binaraherath/Distributed_BMS/images/battery.jpeg

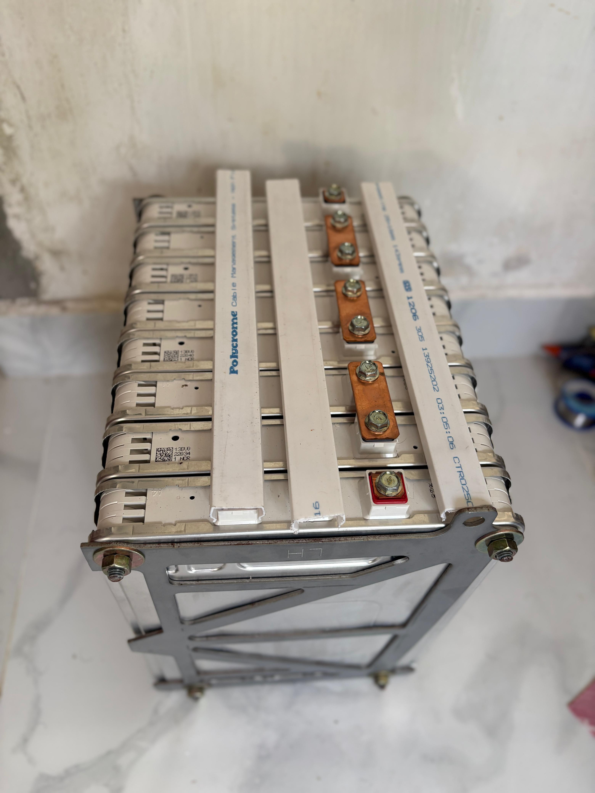
images/battery.jpeg
