binaraherath/Distributed_BMS/images/BQ.png

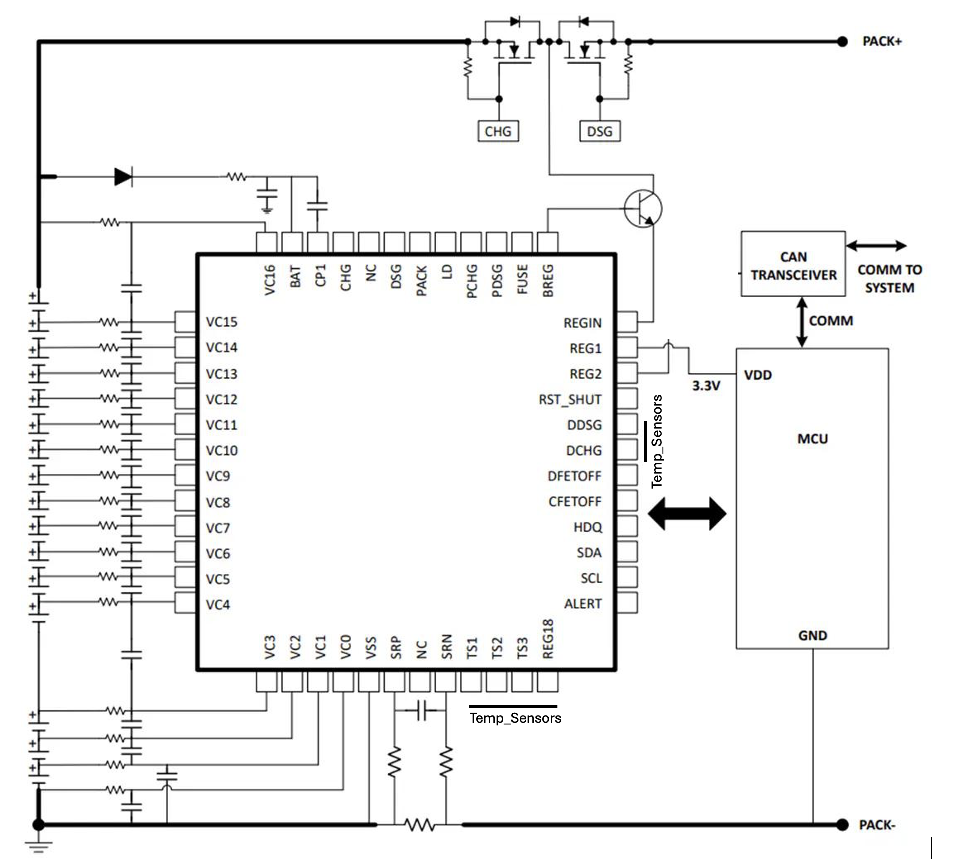
images/BQ.png
