binaraherath/Distributed_BMS/images/node1.png

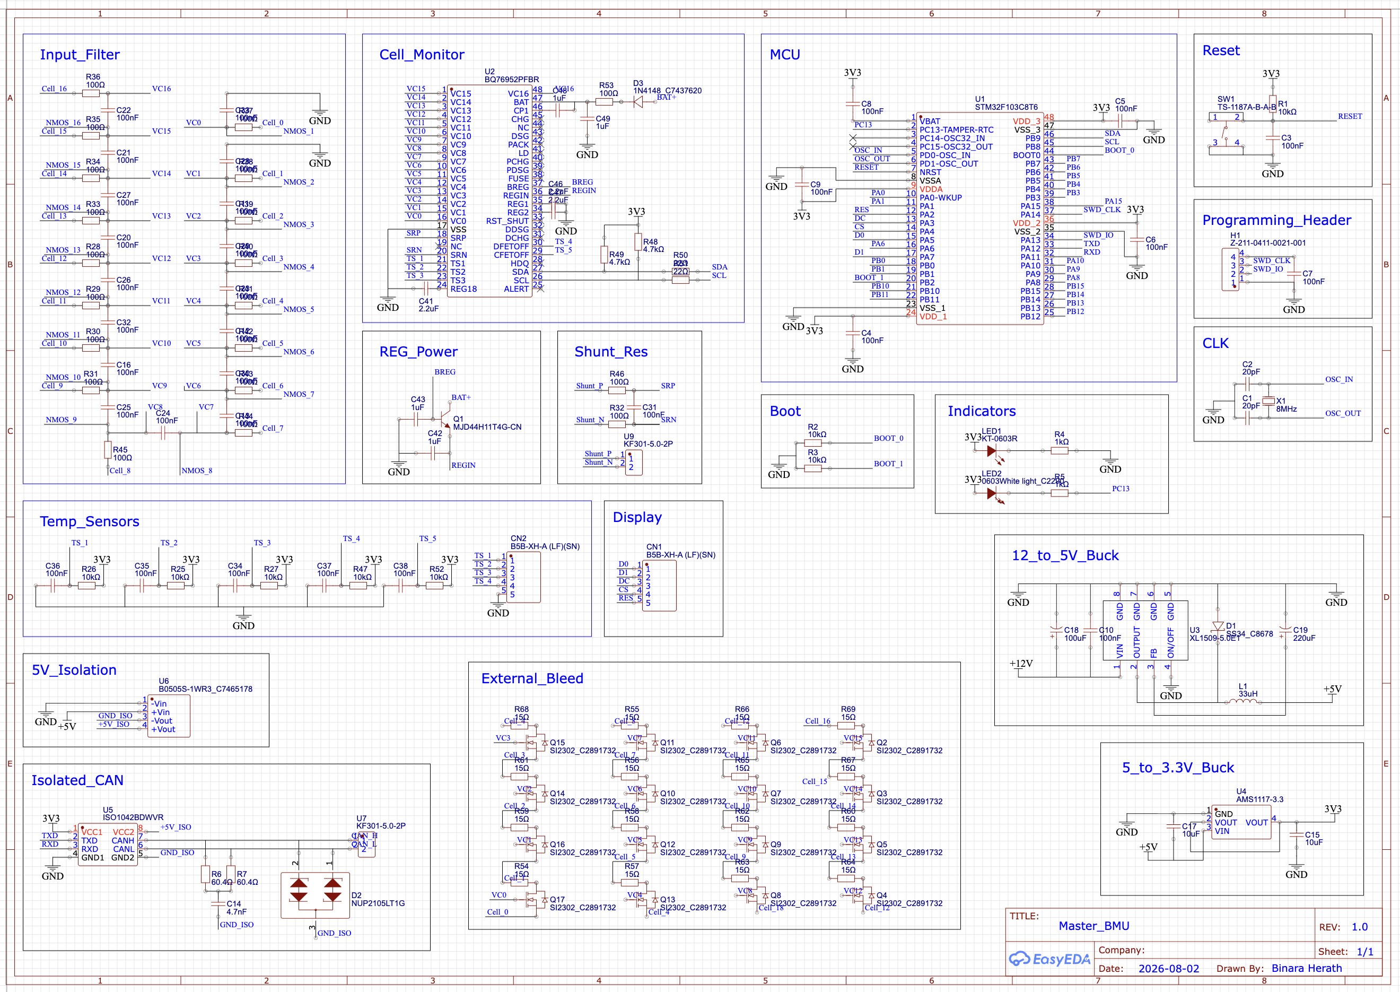
images/node1.png
