binaraherath/Distributed_BMS/images/PCB-2D.png

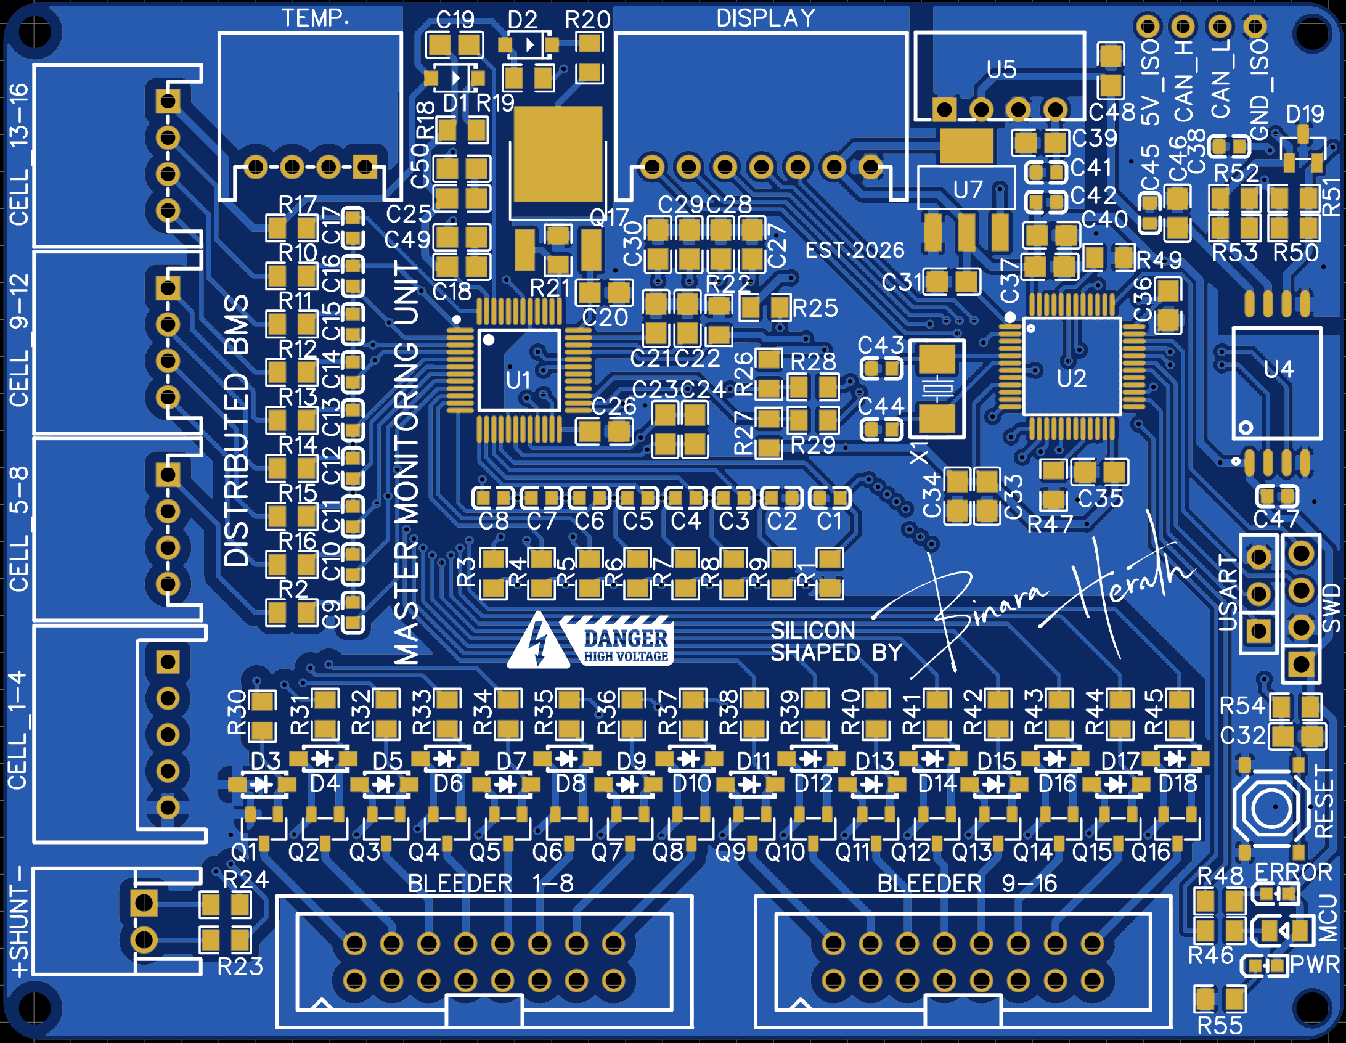
images/PCB-2D.png
