binaraherath/Distributed_BMS/images/prototype.jpeg

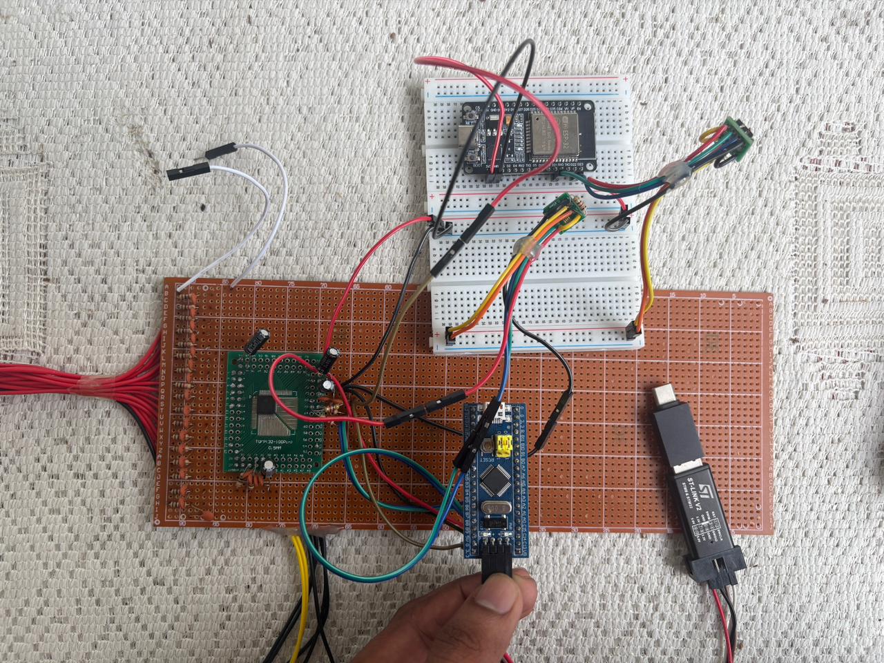
images/prototype.jpeg
