binaraherath/Distributed_BMS/PCB/BOM_bms_2026-09-23.csv

ID | Name | Designator | Footprint | Quantity | Manufacturer Part | Manufacturer | Supplier | Supplier Part | Price | Pins | 3DModel | Contributor | JLCPCB Part Class | link
1 | DC3-2.54-16PAS | BLEEDER_1-8,BLEEDER_9-16 | IDC-TH_16P-P2.54_C3406 | 2 | DC3-2.54-16PAS | ZHOURI(洲日) | LCSC | C2977594 | 0.097 | 16 | IDC-TH_16P-P2.54-V-R2-C8-S2.54 | lcsc | Extended Part | https://item.szlcsc.com/3807.html
2 | S5B-XH-A(LF)(SN) | CELL_1-4 | CONN-TH_5P-P2.50_S5B-XH-A-LF-SN | 1 | S5B-XH-A(LF)(SN) | JST | LCSC | C263757 | 0.158 | 5 | CONN-TH_5P-P2.50_S5B-XH-A-LF-SN | LCSC | Extended Part | https://lcsc.com/product-detail/Wire-To-Board-Wire-To-Wire-Connector_JST-Sales-America_S5B-XH-A-LF-SN_JST-Sales-America-S5B-XH-A-LF-SN_C263757.html
3 | S4B-XH-A (LF)(SN) | CELL_5-8,CELL_9-12,CELL_13-16,TEMP. | CONN-TH_S4B-XH-A-LF-SN | 4 | S4B-XH-A(LF)(SN) | JST | LCSC | C157925 | 0.09 | 4 | CONN-TH_S4B-XH-A-LF-SN | LCSC | Extended Part | https://item.szlcsc.com/169273.html
4 | S7B-XH-A (LF)(SN) | DISPLAY | CONN-TH_S7B-XH-A-LF-SN | 1 | S7B-XH-A(LF)(SN) | JST | LCSC | C157916 | 0.174 | 7 | CONN-TH_S7B-XH-A-LF-SN | LCSC | Extended Part | https://item.szlcsc.com/169273.html
5 | KT-0603R | PWR,ERROR | LED-SMD_L1.6-W0.8-R-RD | 2 | KT-0603R | KENTO | LCSC | C2286 | 0.008 | 2 | LED0603_L1.6-W0.8-H0.6 | lcsc | Basic Part | https://item.szlcsc.com/347796.html
6 | TS-1187A-B-A-B | RESET | SW-SMD_4P-L5.1-W5.1-P3.70-LS6.5-TL_H1.5 | 1 | TS-1187A-B-A-B | XKB Connection(中国星坤) | LCSC | C318884 | 0.021 | 4 | SW-SMD_4P-L5.1-W5.1-P3.70-LS6.5-TL_H1.5 | LCSC | Basic Part | https://item.szlcsc.com/datasheet/TS-1187A-C-6.0-B/299982.html
7 | S2B-XH-A-1 (LF)(SN) | +SHUNT- | CONN-TH_S2B-XH-A-1-LF-SN | 1 | S2B-XH-A-1(LF)(SN) | JST | LCSC | C163035 | 0.1 | 2 | CONN-TH_S2B-XH-A-1-LF-SN | LCSC | Extended Part | https://atta.szlcsc.com/upload/public/pdf/source/20180323/44523D67FD27A22AE4980410C4D95A91.pdf
8 | Header-Male-2.54_1x4 | SWD | HDR-TH_4P-P2.54-V-M | 1 | B-2100S04P-A110 | Ckmtw(灿科盟) | LCSC | C124378 | 0.057 | 4 | HDR-TH_4P-P2.54-M-LI-1X4P | LCSC | Extended Part | https://item.szlcsc.com/502959.html
9 | Header-Female-2.54_1x3 | USART | HDR-TH_3P-P2.54-V-F | 1 | 2.54-1*3P母 | BOOMELE(博穆精密) | LCSC | C146243 | 0.065 | 3 | HDR2.54-F-LI-1X3P | lcsc | Extended Part | https://item.szlcsc.com/562471.html
10 | 0805G (Green) | MCU | LED0805-R-RD | 1 | KT-0805G | KENTO | LCSC | C2297 | 0.017 | 2 | LED0805-RD | lcsc | Basic Part | https://item.szlcsc.com/88042.html
11 | 220nF | C1,C2,C3,C4,C5,C6,C7,C8,C9,C10,C11,C12,C13,C14,C15,C16,C17 | C0603 | 17 | CL10B224KA8NNNC | SAMSUNG(三星) | LCSC | C21120 | 0.014 | 2 | C0603_L1.6-W0.8-H0.8 | lcsc | Basic Part | https://item.szlcsc.com/362304.html
12 | 4.7nF | C38 | C0603 | 1 | 0603B472K500NT | FH(风华) | LCSC | C53987 | 0.009 | 2 | C0603_L1.6-W0.8-H0.8 | lcsc | Basic Part | https://item.szlcsc.com/362304.html
13 | 100nF | C41,C42,C45,C47 | C0603 | 4 | CC0603KRX7R9BB104 | YAGEO(国巨) | LCSC | C14663 | 0.013 | 2 | C0603_L1.6-W0.8-H0.8 | lcsc | Basic Part | https://item.szlcsc.com/362304.html
14 | 30pF | C43,C44 | C0603 | 2 | 0603CG300J500NT | FH(风华) | LCSC | C1658 | 0.008 | 2 | C0603_L1.6-W0.8-H0.8 | lcsc | Basic Part | https://item.szlcsc.com/362304.html
15 | 470nF | C19 | C0805 | 1 | CL21B474KBFNNNE | SAMSUNG(三星) | LCSC | C13967 | 0.023 | 2 | C0805_L2.0-W1.3-H1.3 | lcsc | Basic Part | https://item.szlcsc.com/373011.html
16 | 22nF | C20 | C0805 | 1 | CL21B223KBANNNC | SAMSUNG(三星) | LCSC | C1729 | 0.01 | 2 | C0805_L2.0-W1.3-H1.3 | lcsc | Basic Part | https://item.szlcsc.com/373011.html
17 | 2.2uF | C21,C22,C26,C49,C18 | C0805 | 5 | CL21A225KBQNNNE | SAMSUNG(三星) | LCSC | C377773 | 0.054 | 2 | C0805_L2.0-W1.3-H1.3 | LCSC | Basic Part | https://item.szlcsc.com/373011.html
18 | 100nF | C23,C31,C32,C35,C36,C37 | C0805 | 6 | CC0805KRX7R9BB104 | YAGEO(国巨) | LCSC | C49678 | 0.02 | 2 | C0805_L2.0-W1.3-H1.3 | lcsc | Basic Part | https://item.szlcsc.com/373011.html
19 | 100pF | C24 | C0805 | 1 | CL21C101JBANNNC | SAMSUNG(三星) | LCSC | C1790 | 0.01 | 2 | C0805_L2.0-W1.3-H1.3 | lcsc | Basic Part | https://item.szlcsc.com/373011.html
20 | 2.2nF | C27,C28,C29,C30 | C0805 | 4 | CL21C222JBFNNNE | SAMSUNG(三星) | LCSC | C28260 | 0.026 | 2 | C0805_L2.0-W1.3-H1.3 | lcsc | Basic Part | https://item.szlcsc.com/373011.html
21 | 1uF | C33 | C0805 | 1 | CL21B105KBFNNNE | SAMSUNG(三星) | LCSC | C28323 | 0.04 | 2 | C0805_L2.0-W1.3-H1.3 | lcsc | Basic Part | https://item.szlcsc.com/373011.html
22 | 10nF | C34 | C0805 | 1 | CL21B103KBANNNC | SAMSUNG(三星) | LCSC | C1710 | 0.012 | 2 | C0805_L2.0-W1.3-H1.3 | lcsc | Basic Part | https://item.szlcsc.com/373011.html
23 | 10uF | C39,C40,C46 | C0805 | 3 | CL21A106KAYNNNE | SAMSUNG(三星) | LCSC | C15850 | 0.08 | 2 | C0805_L2.0-W1.3-H1.3 | lcsc | Basic Part | https://item.szlcsc.com/373011.html
24 | 4.7uF | C48 | C0805 | 1 | CL21A475KAQNNNE | SAMSUNG(三星) | LCSC | C1779 | 0.035 | 2 | C0805_L2.0-W1.3-H1.3 | lcsc | Basic Part | https://item.szlcsc.com/373011.html
25 | 1N4148W_C7420318 | D1,D2 | SOD-123_L2.7-W1.6-LS3.7-FD | 2 | 1N4148W | R+O(宏嘉诚) | LCSC | C7420318 | 0.007 | 2 | SOD-123_L2.7-W1.6-LS3.7-FD | lcsc | Extended Part | https://atta.szlcsc.com/upload/public/pdf/source/20180503/C191428_AD0ED457CC768099CBC92C1868282AFA.pdf
26 | B5819W_C8598 | D3,D4,D5,D6,D7,D8,D9,D10,D11,D12,D13,D14,D15,D16,D17,D18 | SOD-123_L2.7-W1.6-LS3.7-RD-1 | 16 | B5819W SL | CJ(江苏长电/长晶) | LCSC | C8598 | 0.028 | 2 | SOD-123_L2.7-W1.6-LS3.7-RD-1 | lcsc | Basic Part | https://atta.szlcsc.com/upload/public/pdf/source/20210423/C2828417_EF1BF8BE3D48F97E320B09B073C89160.pdf
27 | NUP2105LT1G | D19 | SOT-23-3_L2.9-W1.3-P1.90-LS2.4-BL-2 | 1 | NUP2105LT1G | onsemi(安森美) | LCSC | C14486 | 0.084 | 3 | SOT-23-3_L2.9-W1.3-P1.90-LS2.4 | lcsc | Extended Part | https://atta.szlcsc.com/upload/public/pdf/source/20230202/4B050FD87E409CF6352A84D0F2147E80.pdf
28 | MMBT2222A_C8512 | Q1,Q2,Q3,Q4,Q5,Q6,Q7,Q8,Q9,Q10,Q11,Q12,Q13,Q14,Q15,Q16 | SOT-23-3_L2.9-W1.3-P1.90-LS2.4-BR | 16 | MMBT2222A 1P | CJ(江苏长电/长晶) | LCSC | C8512 | 0.018 | 3 | SOT-23-3P_L2.9-W1.3-H1.0-LS2.4-P0.95 | lcsc | Basic Part | https://www.diodes.com/assets/Package-Files/SOT23.pdf
29 | MJD44H11T4G-CN | Q17 | TO-252-2_L6.6-W6.1-P4.57-LS10.0-BR-CW | 1 | MJD44H11T4G-CN | ChipNobo(无边界) | LCSC | C49006717 | 0.27 | 3 | TO-252-2_L6.6-W6.1-P4.57-LS10.0-BR-CW | lcsc | Extended Part | https://atta.szlcsc.com/upload/public/pdf/source/20180730/C256463_B17347F79758AD9067BF3A09DDCB423D.pdf
30 | 100Ω | R1,R2,R3,R4,R5,R6,R7,R8,R9,R10,R11,R12,R13,R14,R15,R16,R18,R23,R24 | R0805 | 19 | 0805W8F1000T5E | UNI-ROYAL(厚声) | LCSC | C17408 | 0.004 | 2 | R0805_L2.0-W1.3-H0.6 | lcsc | Basic Part | https://item.szlcsc.com/142685.html
31 | 20Ω | R17 | R0805 | 1 | 0805W8F200JT5E | UNI-ROYAL(厚声) | LCSC | C17544 | 0.005 | 2 | R0805_L2.0-W1.3-H0.6 | lcsc | Basic Part | https://item.szlcsc.com/142685.html
32 | 10kΩ | R19,R22,R25,R47,R49,R54 | R0805 | 6 | 0805W8F1002T5E | UNI-ROYAL(厚声) | LCSC | C17414 | 0.004 | 2 | R0805_L2.0-W1.3-H0.6 | lcsc | Basic Part | https://item.szlcsc.com/142685.html
33 | 300Ω | R20 | R0805 | 1 | 0805W8F3000T5E | UNI-ROYAL(厚声) | LCSC | C17617 | 0.005 | 2 | R0805_L2.0-W1.3-H0.6 | lcsc | Basic Part | https://item.szlcsc.com/142685.html
34 | 10MΩ | R21 | R0805 | 1 | RMC 0805 10M F N | Tyohm(幸亚电阻) | LCSC | C325949 | 0.008 | 2 | R0805_L2.0-W1.3-H0.6 | LCSC | Extended Part | https://item.szlcsc.com/142685.html
35 | 4.7kΩ | R26,R27 | R0805 | 2 | 0805W8F4701T5E | UNI-ROYAL(厚声) | LCSC | C17673 | 0.005 | 2 | R0805_L2.0-W1.3-H0.6 | lcsc | Basic Part | https://item.szlcsc.com/142685.html
36 | 22Ω | R28,R29 | R0805 | 2 | 0805W8F220JT5E | UNI-ROYAL(厚声) | LCSC | C17561 | 0.005 | 2 | R0805_L2.0-W1.3-H0.6 | lcsc | Basic Part | https://item.szlcsc.com/142685.html
37 | 220Ω | R30,R31,R32,R33,R34,R35,R36,R37,R38,R39,R40,R41,R42,R43,R44,R45 | R0805 | 16 | 0805W8F2200T5E | UNI-ROYAL(厚声) | LCSC | C17557 | 0.006 | 2 | R0805_L2.0-W1.3-H0.6 | lcsc | Basic Part | https://item.szlcsc.com/142685.html
38 | 1kΩ | R46,R48,R55 | R0805 | 3 | 0805W8F1001T5E | UNI-ROYAL(厚声) | LCSC | C17513 | 0.004 | 2 | R0805_L2.0-W1.3-H0.6 | lcsc | Basic Part | https://item.szlcsc.com/142685.html
39 | 120Ω | R50,R51,R52,R53 | R0805 | 4 | 0805W8F1200T5E | UNI-ROYAL(厚声) | LCSC | C17437 | 0.007 | 2 | R0805_L2.0-W1.3-H0.6 | lcsc | Basic Part | https://item.szlcsc.com/142685.html
40 | BQ76952PFBR | U1 | TQFP-48_L7.0-W7.0-P0.50-LS9.0-BL | 1 | BQ76952PFBR | TI(德州仪器) | LCSC | C2862742 | 3.309 | 48 | TQFP-48_L7.0-W7.0-H1.2-LS9.0-P0.50 | LCSC | Extended Part | https://item.szlcsc.com/79128.html
41 | STM32F103C8T6 | U2 | LQFP-48_L7.0-W7.0-P0.50-LS9.0-BL | 1 | STM32F103C8T6 | ST(意法半导体) | LCSC | C8734 | 1.626 | 48 | LQFP-48_L7.0-W7.0-H1.4-LS9.0-P0.50 | lcsc | Extended Part | https://atta.szlcsc.com/upload/public/pdf/source/20190808/C411336_D1D2DF7683029D856BA010BA7A5BF7EA.pdf
42 | ISO1042BDWVR | U4 | SOIC-8_L5.9-W7.5-P1.27-LS11.5-BL | 1 | ISO1042BDWVR | TI(德州仪器) | LCSC | C484409 | 2.45 | 8 | SOIC-8_L5.8-W7.5-H2.3-LS11.5-P1.27 | LCSC | Extended Part | https://item.szlcsc.com/209718.html
43 | B0505S-1WR3L_C22749776 | U5 | PWRM-TH_B0505S-1WR3L | 1 | B0505S-1WR3L | YLPTEC(易川) | LCSC | C22749776 | 1.01 | 4 | PWRM-TH_B0505S-1WR3L | lcsc | Extended Part | https://atta.szlcsc.com/upload/public/pdf/source/20240807/C6648B843069D054DBBCD1ED78E6F415.pdf
44 | AMS1117-3.3 | U7 | SOT-223-3_L6.5-W3.4-P2.30-LS7.0-BR | 1 | AMS1117-3.3 | Advanced Monolithic Systems | LCSC | C6186 | 0.22 | 4 | SOT-223-4P_L6.5-W3.5-H1.6-LS7.0-P2.30 | lcsc | Basic Part | https://item.szlcsc.com/410724.html
45 | 8MHz | X1 | CRYSTAL-SMD_L5.0-W3.2 | 1 | X50328MSB2GI | YXC(扬兴晶振) | LCSC | C115962 | 0.248 | 2 | CRYSTAL-SMD_L5.0-W3.2 | lcsc | Basic Part | https://atta.szlcsc.com/upload/public/pdf/source/20181112/C254399_C5BBDD3824DCEC70A37F176D8FB90B40.pdf
46 | 220pF | C50,C25 | C0805 | 2 | CC0805KRX7R9BB221 | YAGEO(国巨) | LCSC | C107145 | 0.01 | 2 | C0805_L2.0-W1.3-H1.3 | lcsc | Basic Part | https://item.szlcsc.com/373011.html
