binaraherath/Distributed_BMS/(list of files, drawings)

Other design files:
PCB/PCB_PCB_bms_2026-09-23.json
PCB/SCH_bms_2026-09-23.json
