binaraherath/Distributed_BMS/BMS_Node1/Core/Src/main.c

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
/* Includes ------------------------------------------------------------------*/
#include "main.h"

/* USER CODE BEGIN Includes */
#include "bms_config.h"
#include "bq76952.h"
#include "bms_app.h"
#include "bms_can.h"
#if (BMS_USE_OLED == 1)
#include "ssd1306.h"
#endif
#include <stdio.h>
#include <string.h>
/* USER CODE END Includes */

CAN_HandleTypeDef hcan;

I2C_HandleTypeDef hi2c1;

SPI_HandleTypeDef hspi1;

UART_HandleTypeDef huart1;

IWDG_HandleTypeDef hiwdg;

/* USER CODE BEGIN PV */
static volatile bool s_bq_alert = false;   /* set by the BQ ALERT EXTI */
/* USER CODE END PV */

void SystemClock_Config(void);
static void MX_GPIO_Init(void);
static void MX_CAN_Init(void);
static void MX_I2C1_Init(void);
static void MX_USART1_UART_Init(void);
static void MX_SPI1_Init(void);
static void MX_IWDG_Init(void);
/* USER CODE BEGIN PFP */
static void DebugPrint(const char *s);
static void StartupSelfTest(void);
/* USER CODE END PFP */

/* USER CODE BEGIN 0 */

static void DebugPrint(const char *s)
{
#if (BMS_USE_UART_DEBUG == 1)
    HAL_UART_Transmit(&huart1, (uint8_t *)s, (uint16_t)strlen(s), 100);
#else
    (void)s;
#endif
}

/**
 * Bring the BQ76952 up and prove it is configured the way we think it is.
 * Any failure here latches a fault -- the node keeps running and keeps
 * reporting, but the safety output stays low.
 */
static void StartupSelfTest(void)
{
    char msg[80];
    BQ_Status_t st;

    BQ76952_Attach(&hi2c1);

    st = BQ76952_Probe();
    if (st != BQ_OK) {
        snprintf(msg, sizeof(msg), "BQ probe FAILED: %s\r\n",
                 BQ76952_StatusName(st));
        DebugPrint(msg);
        g_bms.faults |= BMS_FAULT_BQ_COMMS;
        return;
    }
    DebugPrint("BQ76952 detected (0x7695)\r\n");

    st = BQ76952_Configure();
    if (st != BQ_OK) {
        snprintf(msg, sizeof(msg), "BQ config FAILED: %s\r\n",
                 BQ76952_StatusName(st));
        DebugPrint(msg);
        g_bms.faults |= BMS_FAULT_BQ_CONFIG;
        return;
    }
    DebugPrint("BQ76952 configured and verified\r\n");
}

/* CAN RX interrupt. Reading the message clears the pending flag, so this
 * callback must actually drain the FIFO or the ISR will re-fire forever. */
void HAL_CAN_RxFifo0MsgPendingCallback(CAN_HandleTypeDef *h)
{
    (void)h;
    BMS_CAN_Poll();
}

void HAL_CAN_ErrorCallback(CAN_HandleTypeDef *h)
{
    if (READ_BIT(h->Instance->ESR, CAN_ESR_BOFF) != 0u) {
        g_bms.faults |= BMS_FAULT_CAN_BUS_OFF;
    }
}

void HAL_GPIO_EXTI_Callback(uint16_t pin)
{
    if (pin == BQ_ALERT_Pin) s_bq_alert = true;
}

/* USER CODE END 0 */

/**
  * @brief  The application entry point.
  * @retval int
  */
int main(void)
{
  /* USER CODE BEGIN 1 */
  uint32_t t_meas = 0, t_fast = 0, t_slow = 0, t_hb = 0, t_bal = 0, t_oled = 0;
  uint32_t last_faults = 0;
  /* USER CODE END 1 */

  /* MCU Configuration--------------------------------------------------------*/
  HAL_Init();

  SystemClock_Config();

  /* Initialize all configured peripherals */
  MX_GPIO_Init();
  MX_CAN_Init();
  MX_I2C1_Init();
  MX_USART1_UART_Init();
  MX_SPI1_Init();

  /* USER CODE BEGIN 2 */
  DebugPrint("\r\n=== 16S BMS monitoring node ===\r\n");

  BMS_App_Init();

  if (BMS_CAN_Init(&hcan) != HAL_OK) {
      DebugPrint("CAN init FAILED\r\n");
      g_bms.faults |= BMS_FAULT_CAN_BUS_OFF;
  } else {
      DebugPrint("CAN 500 kbit/s up\r\n");
  }

#if (BMS_USE_OLED == 1)
  SSD1306_Init(&hspi1);
#endif

  StartupSelfTest();

  /* Watchdog last, so a slow BQ configuration cannot trip it. */
  MX_IWDG_Init();
  /* USER CODE END 2 */

  /* Infinite loop */
  /* USER CODE BEGIN WHILE */
  while (1)
  {
    uint32_t now = HAL_GetTick();

    /* --- 100 ms: measure and evaluate ---------------------------------- */
    if ((now - t_meas) >= BMS_MEAS_PERIOD_MS) {
        t_meas = now;
        BMS_App_MeasureAndEvaluate();

        if (s_bq_alert) {
            s_bq_alert = false;
            /* The next scheduled read already picks up the new safety status;
             * the flag is here so you can see the pin working during bring-up. */
        }
    }

    /* --- 100 ms: fast CAN group ---------------------------------------- */
    if ((now - t_fast) >= BMS_CAN_FAST_PERIOD_MS) {
        t_fast = now;
        BMS_CAN_SendFast();
    }

    /* --- immediate fault frame on any change --------------------------- */
    if (g_bms.faults != last_faults) {
        last_faults = g_bms.faults;
        BMS_CAN_SendFaultsNow();
    }

    /* --- 500 ms: slow CAN group ---------------------------------------- */
    if ((now - t_slow) >= BMS_CAN_SLOW_PERIOD_MS) {
        t_slow = now;
        BMS_CAN_SendSlow();
    }

    /* --- 1 s: heartbeat, housekeeping, LED ----------------------------- */
    if ((now - t_hb) >= BMS_CAN_HEARTBEAT_MS) {
        t_hb = now;
        BMS_App_Tick1s();
        BMS_CAN_SendHeartbeat();
        HAL_GPIO_TogglePin(HB_LED_GPIO_Port, HB_LED_Pin);
    }

    /* --- 1 s: balancing ------------------------------------------------- */
    if ((now - t_bal) >= BMS_BALANCE_PERIOD_MS) {
        t_bal = now;
        BMS_App_UpdateBalancing();
    }

    /* --- 250 ms: display ------------------------------------------------ */
#if (BMS_USE_OLED == 1)
    if ((now - t_oled) >= BMS_OLED_PERIOD_MS) {
        t_oled = now;
        SSD1306_RenderBms();
    }
#else
    (void)t_oled;
#endif

    /* --- backstop RX poll ---------------------------------------------- */
    BMS_CAN_Poll();

    /* --- watchdog -------------------------------------------------------
     * Only refresh while measurements are fresh. If the BQ read loop stalls,
     * the watchdog resets the MCU, BMS_OK drops to its pull-down and the
     * system controller opens the contactors. That is the point of it.      */
#if (BMS_USE_IWDG == 1)
    if ((HAL_GetTick() - g_bms.last_good_meas_ms) < BMS_BQ_COMMS_TIMEOUT_MS ||
        (g_bms.faults & BMS_FAULT_BQ_COMMS)) {
        HAL_IWDG_Refresh(&hiwdg);
    }
#endif

    /* USER CODE END WHILE */

    /* USER CODE BEGIN 3 */
  }
  /* USER CODE END 3 */
}

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
