binaraherath/Distributed_BMS/Firmware/Node1_Monitoring_Unit/Core/Inc/main.h

#define LED_MCU_Pin GPIO_PIN_13
#define LED_MCU_GPIO_Port GPIOC
#define OLED_RES_Pin GPIO_PIN_2
#define OLED_RES_GPIO_Port GPIOA
#define OLED_DC_Pin GPIO_PIN_3
#define OLED_DC_GPIO_Port GPIOA
#define OLED_CS_Pin GPIO_PIN_4
#define OLED_CS_GPIO_Port GPIOA
#define LED_ERROR_Pin GPIO_PIN_13
#define LED_ERROR_GPIO_Port GPIOB
#define BQ_RST_SHUT_Pin GPIO_PIN_14
#define BQ_RST_SHUT_GPIO_Port GPIOB
#define BQ_ALERT_Pin GPIO_PIN_5
#define BQ_ALERT_GPIO_Port GPIOB
#define BQ_ALERT_EXTI_IRQn EXTI9_5_IRQn
