binaraherath/Distributed_BMS/Software/backend/src/main/java/io/github/binaraherath/dbms/auth/SecurityConfig.java

package io.github.binaraherath.dbms.auth;

import java.nio.charset.StandardCharsets;

import javax.crypto.SecretKey;
import javax.crypto.spec.SecretKeySpec;

import org.springframework.context.annotation.Bean;
import org.springframework.context.annotation.Configuration;
import org.springframework.http.HttpMethod;
import org.springframework.security.authentication.AuthenticationManager;
import org.springframework.security.authentication.ProviderManager;
import org.springframework.security.authentication.dao.DaoAuthenticationProvider;
import org.springframework.security.config.annotation.method.configuration.EnableMethodSecurity;
import org.springframework.security.config.annotation.web.builders.HttpSecurity;
import org.springframework.security.config.annotation.web.configurers.AbstractHttpConfigurer;
import org.springframework.security.config.http.SessionCreationPolicy;
import org.springframework.security.core.userdetails.User;
import org.springframework.security.core.userdetails.UserDetailsService;
import org.springframework.security.core.userdetails.UsernameNotFoundException;
import org.springframework.security.crypto.factory.PasswordEncoderFactories;
import org.springframework.security.crypto.password.PasswordEncoder;
import org.springframework.security.oauth2.jose.jws.MacAlgorithm;
import org.springframework.security.oauth2.jwt.JwtDecoder;
import org.springframework.security.oauth2.jwt.JwtEncoder;
import org.springframework.security.oauth2.jwt.NimbusJwtDecoder;
import org.springframework.security.oauth2.jwt.NimbusJwtEncoder;
import org.springframework.security.web.SecurityFilterChain;

import com.nimbusds.jose.jwk.source.ImmutableSecret;

import io.github.binaraherath.dbms.config.BmsProperties;
import io.github.binaraherath.dbms.user.AppUserRepository;
import jakarta.servlet.DispatcherType;

/**
 * Stateless security: the login endpoint issues a signed JWT inside an httpOnly,
 * SameSite=Strict cookie. Spring's OAuth2 resource-server support validates it on
 * every request. Roles are checked per endpoint with {@code @PreAuthorize}.
 */
@Configuration(proxyBeanMethods = false)
@EnableMethodSecurity
class SecurityConfig {

    @Bean
    SecretKey jwtKey(BmsProperties props) {
        byte[] secret = props.security().jwtSecret().getBytes(StandardCharsets.UTF_8);
        if (secret.length < 32) {
            throw new IllegalStateException("bms.security.jwt-secret must be at least 32 bytes");
        }
        return new SecretKeySpec(secret, "HmacSHA256");
    }

    @Bean
    JwtEncoder jwtEncoder(SecretKey key) {
        return new NimbusJwtEncoder(new ImmutableSecret<>(key));
    }

    @Bean
    JwtDecoder jwtDecoder(SecretKey key) {
        return NimbusJwtDecoder.withSecretKey(key).macAlgorithm(MacAlgorithm.HS256).build();
    }

    @Bean
    PasswordEncoder passwordEncoder() {
        return PasswordEncoderFactories.createDelegatingPasswordEncoder();   // BCrypt
    }

    @Bean
    UserDetailsService userDetailsService(AppUserRepository users) {
        return username -> users.findByUsername(username)
                .map(u -> User.withUsername(u.getUsername())
                        .password(u.getPasswordHash())
                        .roles(u.getRole().name())
                        .disabled(!u.isEnabled())
                        .build())
                .orElseThrow(() -> new UsernameNotFoundException(username));
    }

    @Bean
    AuthenticationManager authenticationManager(UserDetailsService uds, PasswordEncoder encoder) {
        DaoAuthenticationProvider provider = new DaoAuthenticationProvider(uds);
        provider.setPasswordEncoder(encoder);
        return new ProviderManager(provider);
    }

    @Bean
    SecurityFilterChain securityFilterChain(HttpSecurity http, CookieBearerTokenResolver tokenResolver,
                                            UserJwtAuthenticationConverter jwtConverter,
                                            ProblemJsonSecurityHandler problems) throws Exception {
        http
                // No CSRF token: the session cookie is SameSite=Strict and every write is JSON.
                .csrf(AbstractHttpConfigurer::disable)
                .sessionManagement(s -> s.sessionCreationPolicy(SessionCreationPolicy.STATELESS))
                .httpBasic(AbstractHttpConfigurer::disable)
                .formLogin(AbstractHttpConfigurer::disable)
                .authorizeHttpRequests(auth -> auth
                        // SSE and error pages are re-dispatched; the original request was already checked
                        .dispatcherTypeMatchers(DispatcherType.ASYNC, DispatcherType.ERROR).permitAll()
                        .requestMatchers(HttpMethod.POST, "/api/v1/auth/login", "/api/v1/auth/logout").permitAll()
                        .requestMatchers("/api/docs", "/api/docs/**", "/api/swagger-ui/**",
                                "/actuator/health", "/actuator/health/**").permitAll()
                        .requestMatchers("/api/**").authenticated()
                        .anyRequest().denyAll())
                .oauth2ResourceServer(rs -> rs
                        .bearerTokenResolver(tokenResolver)
                        .jwt(jwt -> jwt.jwtAuthenticationConverter(jwtConverter))
                        .authenticationEntryPoint(problems)
                        .accessDeniedHandler(problems))
                .exceptionHandling(ex -> ex
                        .authenticationEntryPoint(problems)
                        .accessDeniedHandler(problems));
        return http.build();
    }
}
