binaraherath/Distributed_BMS/(commit log)

2026-07-13 Add system architecture flowchart to README
    Added a flowchart diagram to illustrate the system architecture.
2026-08-06 Added initial STM32 BMS Node 1 firmware
2026-09-01 prototype photo
2026-09-01 Add prototype image to README
    Added a new image to the README for better visualization.
2026-09-01 Battery photo
2026-09-01 Add Battery image to README
    Added a new image 'Battery.jpeg' to the README.
2026-10-13 Update PCB images section in README
    Removed descriptions for 'Inner 1' and 'Bottom' sections in the table.
